fablabfacens/Estufa-Filamentos---V2/Estrutura_CAD/Estufa_Filamentos_cortes_porta_R00.dxf

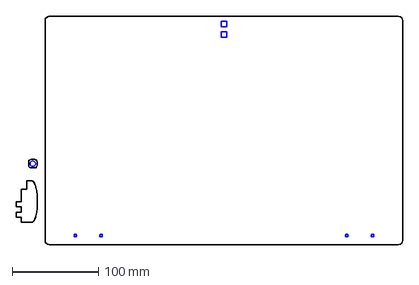
[picture p10: CAD file, 2023-10-19]
Estrutura_CAD/Estufa_Filamentos_cortes_porta_R00.dxf
448.6 x 265.0 mm
