fablabfacens/Estufa-Filamentos---V2/Modelos_3D_Display/Carenagem_Estufa_R01.stl

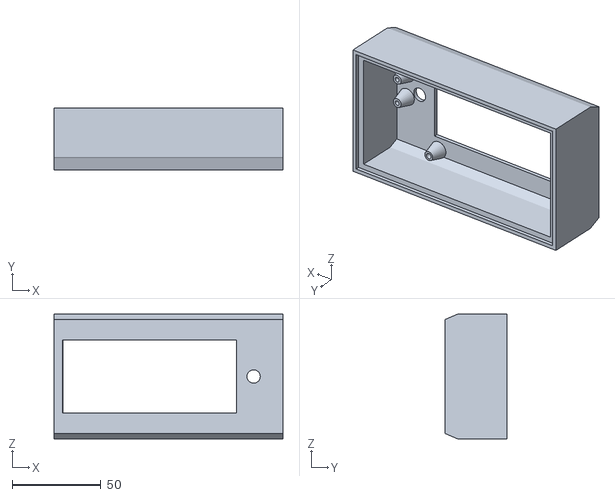
[picture p11: CAD file, 2023-10-19]
Modelos_3D_Display/Carenagem_Estufa_R01.stl
128.7 x 35.0 x 70.0
