fablabfacens/Estufa-Filamentos---V2/Placas/Base_PCB/base_PCB.dxf

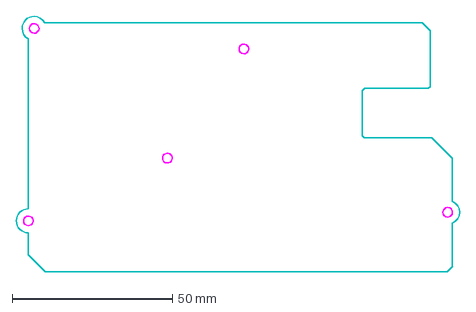
[picture p12: CAD file, 2023-10-19]
Placas/Base_PCB/base_PCB.dxf
138.2 x 79.5 mm
