fablabfacens/Estufa-Filamentos---V2/Placas/prototipos_finais.dxf

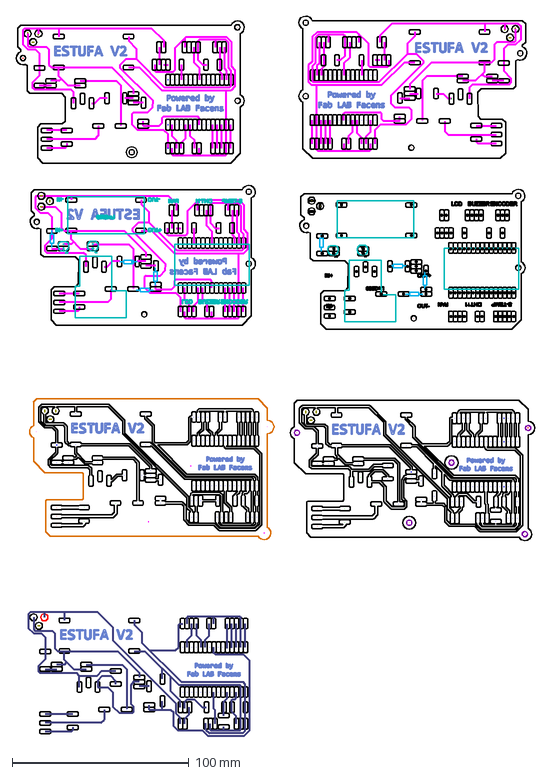
[picture p13: CAD file, 2023-10-19]
Placas/prototipos_finais.dxf
293.1 x 407.0 mm
