fablabfacens/Estufa-Filamentos---V2/Estrutura_CAD/Dobradiças_Porta.STL

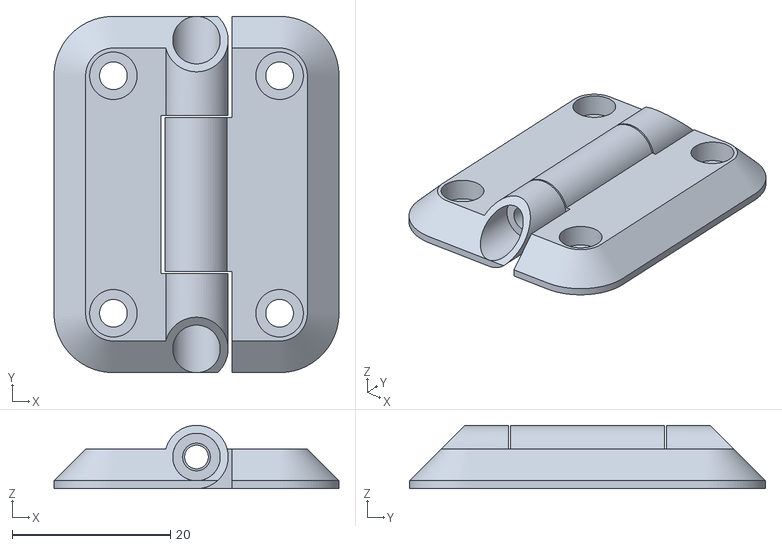
[picture p14: CAD file, 2023-10-19]
Estrutura_CAD/Dobradiças_Porta.STL
36.0 x 45.0 x 8.00
