fablabfacens/Estufa-Filamentos---V2/Modelos_3D_Display/Carenagem_Estufa_R02.stl

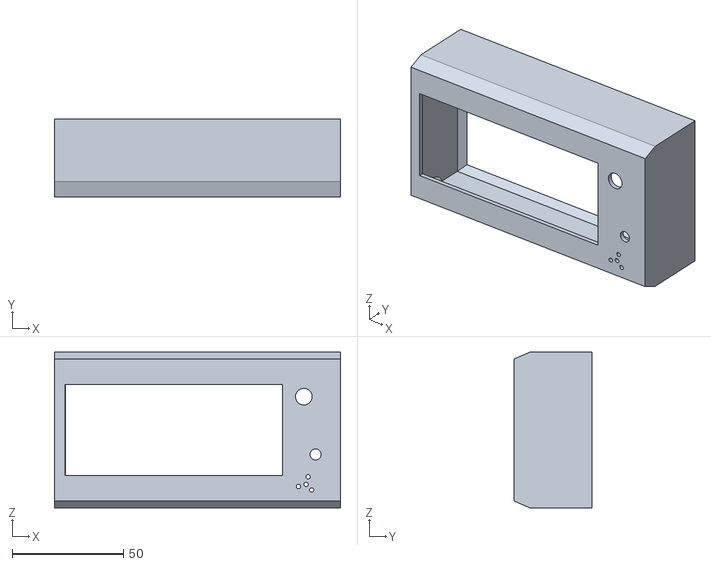
[picture p15: CAD file, 2023-10-19]
Modelos_3D_Display/Carenagem_Estufa_R02.stl
128.7 x 35.0 x 70.0
