fablabfacens/Estufa-Filamentos---V2/Placas/Base_PCB/Base_PCB_Estufa.stl

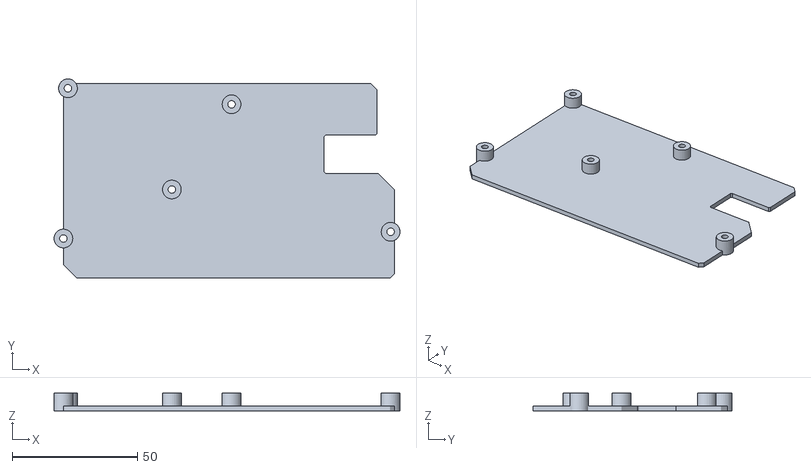
[picture p16: CAD file, 2023-10-19]
Placas/Base_PCB/Base_PCB_Estufa.stl
138.2 x 79.5 x 7.00
