fablabfacens/Estufa-Filamentos---V2/Placas/Trilhas e Pads.dxf

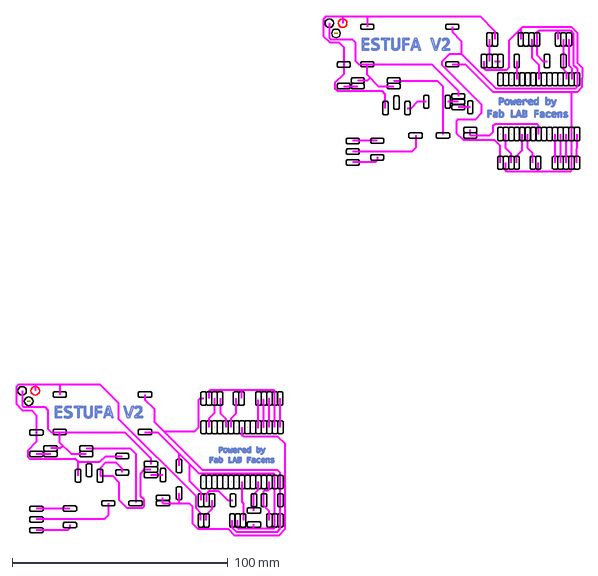
[picture p17: CAD file, 2023-10-19]
Placas/Trilhas e Pads.dxf
262.6 x 240.8 mm
