fablabfacens/Estufa-Filamentos---V2/Estrutura_CAD/Parte_Interna_MDF3mm.dxf

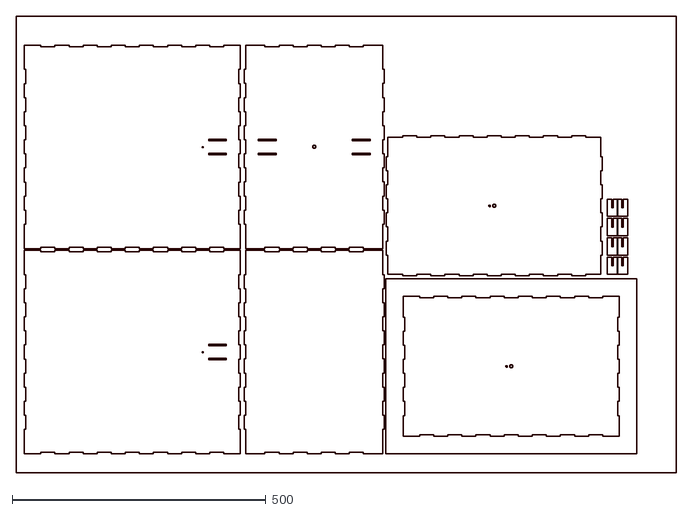
[picture p18: CAD file, 2023-10-19]
Estrutura_CAD/Parte_Interna_MDF3mm.dxf
1300.0 x 900.0
