fablabfacens/Estufa-Filamentos---V2/Placas/arquivo_final_mesa_precisao.dxf

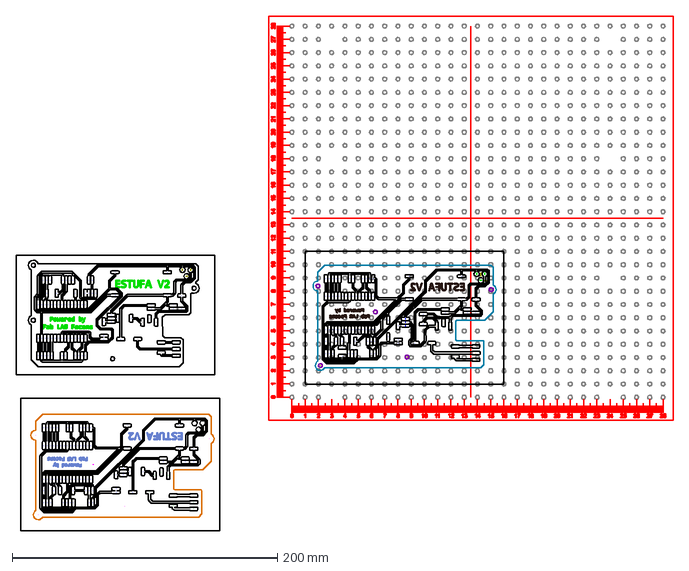
[picture p19: CAD file, 2023-10-19]
Placas/arquivo_final_mesa_precisao.dxf
495.6 x 388.3 mm
