fablabfacens/Estufa-Filamentos---V2/Estrutura_CAD/Estufa_Filamentos_cortes_R01.dxf

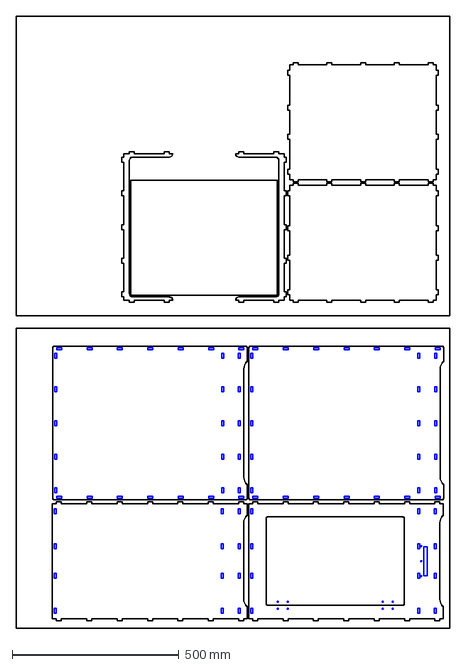
[picture p20: CAD file, 2023-10-19]
Estrutura_CAD/Estufa_Filamentos_cortes_R01.dxf
1300.0 x 1836.9 mm
