fablabfacens/Estufa-Filamentos---V2/Placas/Trilhas_Pads_Borda.dxf

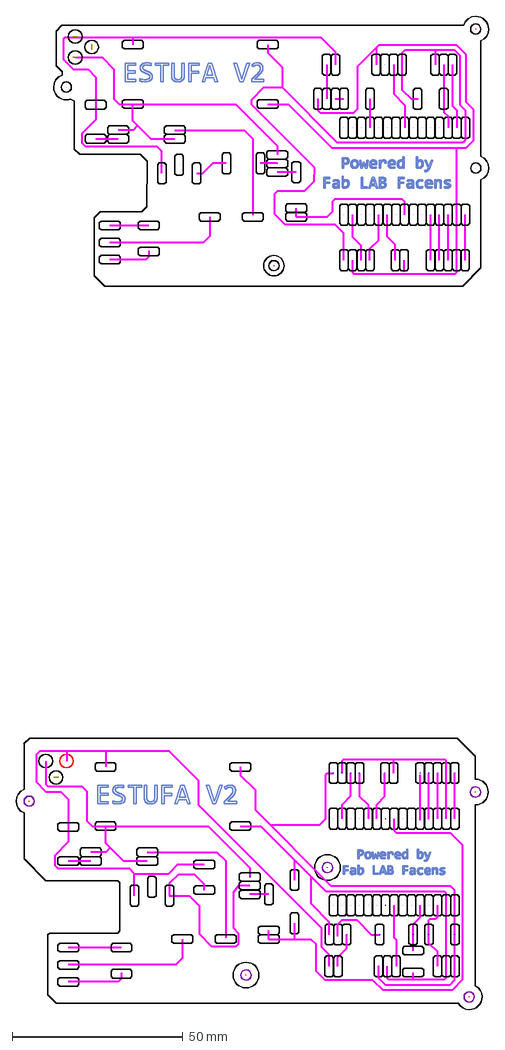
[picture p21: CAD file, 2023-10-19]
Placas/Trilhas_Pads_Borda.dxf
138.3 x 290.8 mm
