fablabfacens/Estufa-Filamentos---V2/Placas/MapeamentoPadsEstufaV2-Nicolas.dxf

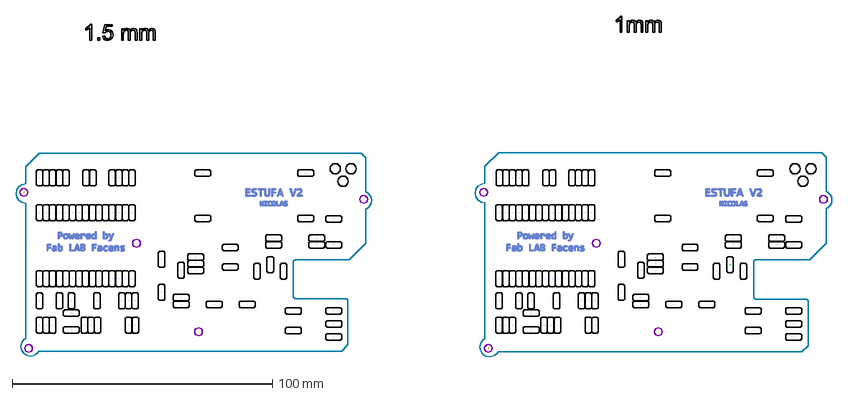
[picture p22: CAD file, 2023-10-19]
Placas/MapeamentoPadsEstufaV2-Nicolas.dxf
313.7 x 131.0 mm
