fablabfacens/Estufa-Filamentos---V2/(list of files, drawings)

Other design files:
Placas/diagramaEletricoEstufa.fzz
