fablabfacens/Estufa-Filamentos---V2/(commit log)

2023-10-19 Primeiro test
    [Base_PCB_Estufa.stl, Carenagem_Estufa_R01.stl, Carenagem_Estufa_R02.stl, Dobradiças.STL, Estufa_Filamentos_cortes_R01.dxf, Estufa_Filamentos_cortes_porta_R00.dxf, MapeamentoPadsEstufaV2-Nicolas.dxf, Parte_Interna_MDF3mm.dxf]
2023-10-19 Atualização na organização dos itens!
    [Base_PCB_Estufa.stl, Carenagem_Estufa_R01.stl, Carenagem_Estufa_R02.stl, Dobradiças.STL, base_PCB.dxf, diagramaEletricoEstufa.fzz]
2023-10-19 Atualizacao na organizacao e adicionado arquivos .dxf da placa
    [Base_PCB_Estufa.stl, Carenagem_Estufa_R01.stl, Carenagem_Estufa_R02.stl, Dobradiças_Porta.STL, Trilhas e Pads.dxf, Trilhas_Pads_Borda.dxf, arquivo_final_mesa_precisao.dxf, base_PCB.dxf]
